akih-san/EMU8088_57Q_CPM86/tool/read_me.txt

mkinc.c

バイナリファイルから、ファームウェアに取り込む
インクルードファイルを作成するツールです。

それぞれの開発環境に合わせて、コンパイルして
実行ファイルを作成してください。

一応Windows用のmkinc.exeを添付していますが、
セキュリティが働いて実行できないかもしれません。
その場合は、開発マシンでコンパイルし、exeファイルを
作成してください。
