akih-san/EMU8088_57Q_CPM86/i88/Make include file.txt

＜cbios.incの作成方法＞

8086のアセンブラは、Macro Assembler AS V1.42を使用しています。
http://john.ccac.rwth-aachen.de:8000/as/

「PowerShell」のスクリプトを使用するため、windowsのターミナルは、
「Windows PowerShell」を使用してください。

初期状態では、スクリプトの実行が許可されていないため、
管理者権限でWindows PowerShellを起動し、以下の文を実行してください。

PowerShell Set-ExecutionPolicy RemoteSigned

上記コマンドを実行後は、管理者権限は必要ありません。
ノーマル権限のWindows PowerShellでスクリプトが使えるようになります。

インクルードファイルを作成するためのバッチファイルが用意されていますので、
バッチファイルを実行することで、インクルードファイルが自動的に作成されます。
Windows PowerShellを立ち上げて、作業ディレクトリへ移動してバッチファイルを
実行します。

（バッチコマンド）
./i88make.bat

作成されるインクルードファイル

1) unimon_8086.inc
2) cbios.inc

＜cbios.incの作成に関しての補足説明＞

1. ソースファイルをアセンブルする。

(コマンド）
asw -L cbios.asm

２．アセンブル後の中間ファイルから、２つのバイナリファイルを作る。
    プログラムがcodeと、dataで分かれているため、それぞれのバイナリを
    作成する必要がある。
    
(コマンド）
p2bin cbios.p cbios_code.bin -segment code
p2bin cbios.p cbios_data.bin -segment data

３．２つのバイナリファイルを１つに結合する。

(コマンド）
Get-Content cbios_*.bin -Encoding Byte | Set-Content cbios.bin -Encoding Byte

４．cbios.binからインクルードファイルを作成する

添付してあるmkinc.exeを実行して、インクルードファイルを作成する。
mkinc.exeの出力は、コンソールになっているので、パイプ「｜」または、リダイレクト「>」を
用いてファイルに出力する。

(コマンド）
.\mkinc.exe .\cbios.bin | sc cbios.inc
