akih-san/EMU8088_57Q_CPM86/circuit diagram.pdf

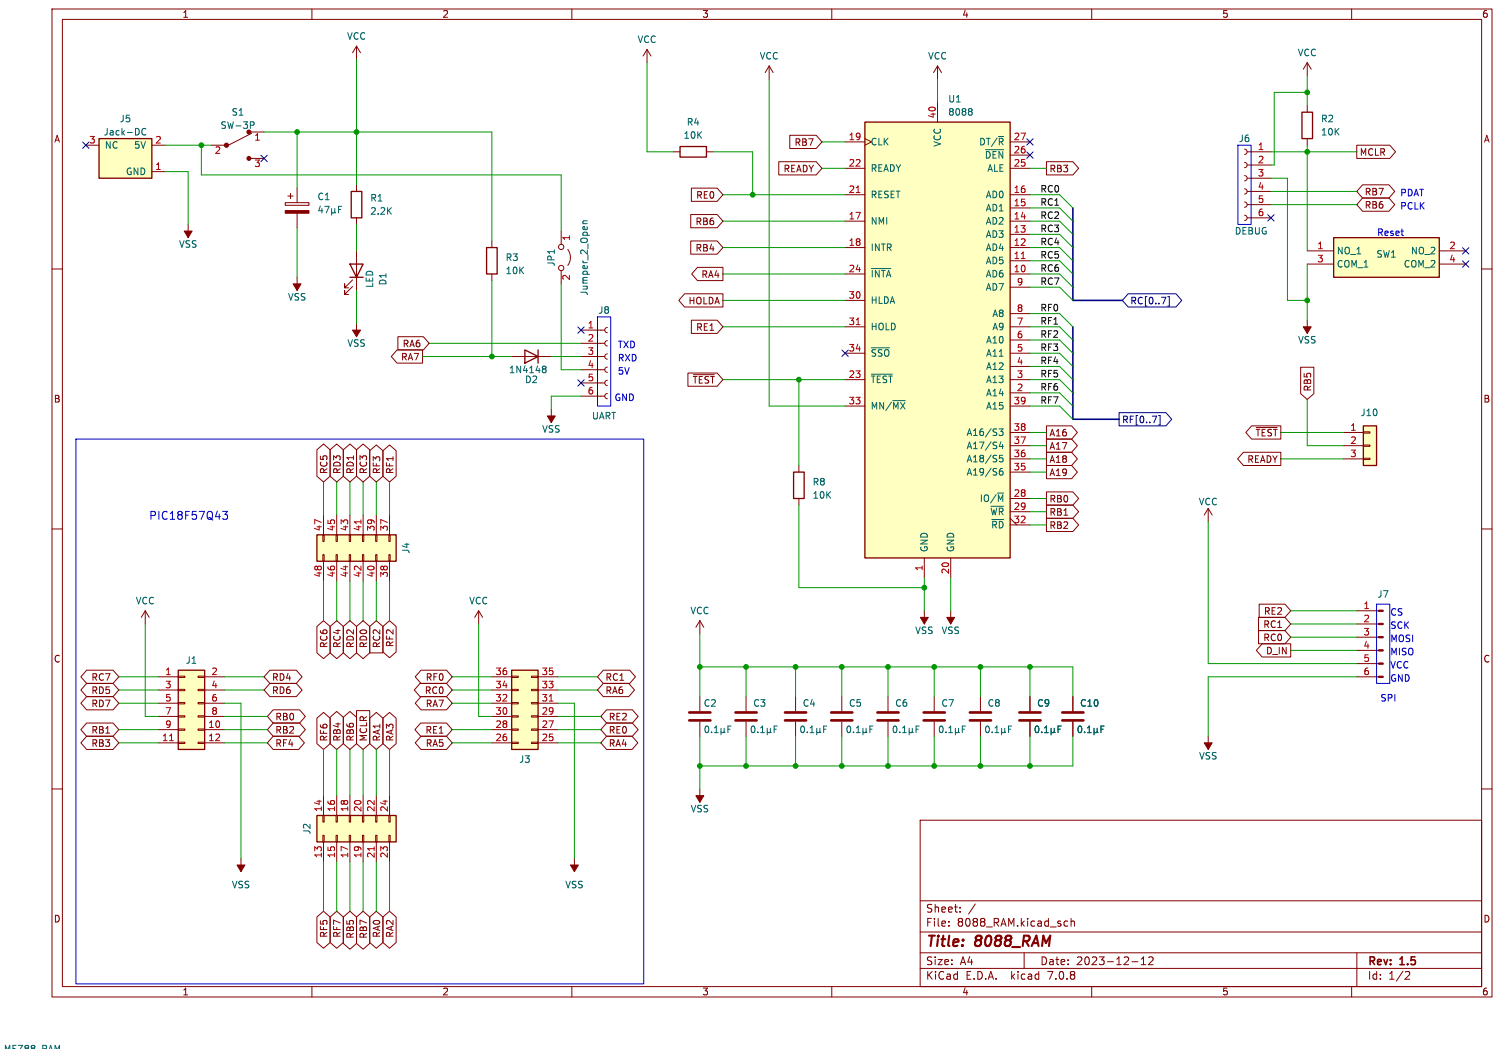
[picture p5: page 1]

PDAT PCLK
Reset VCC GND MISO

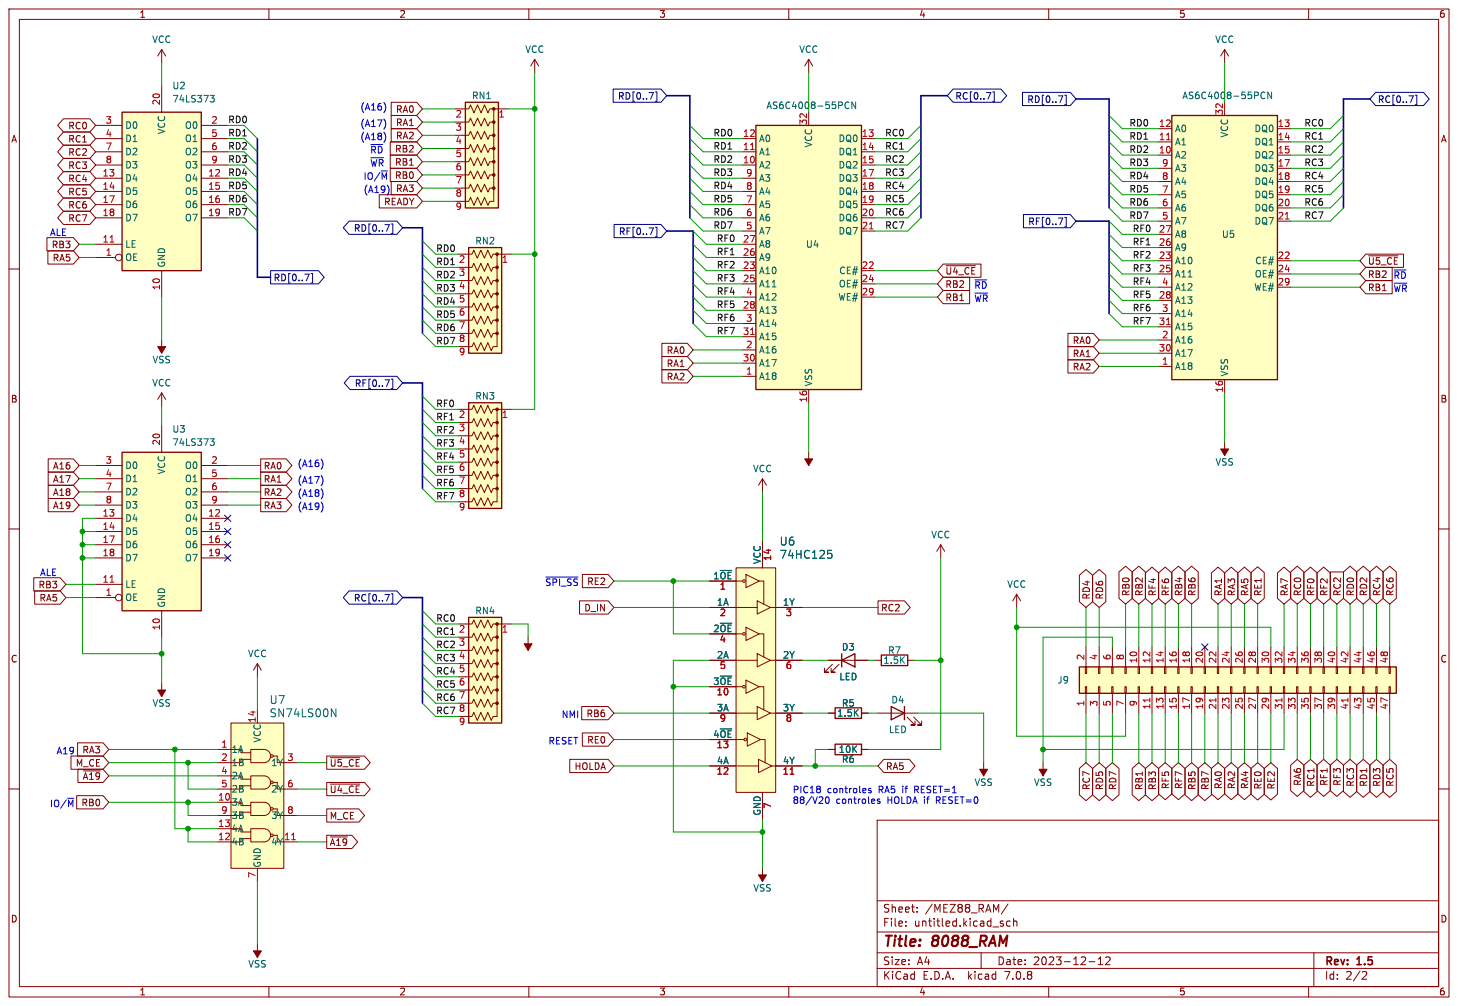
[picture p6: page 2]
