akih-san/EMU8088_57Q_CPM86/PCB_data/8088_RAM回路図.pdf

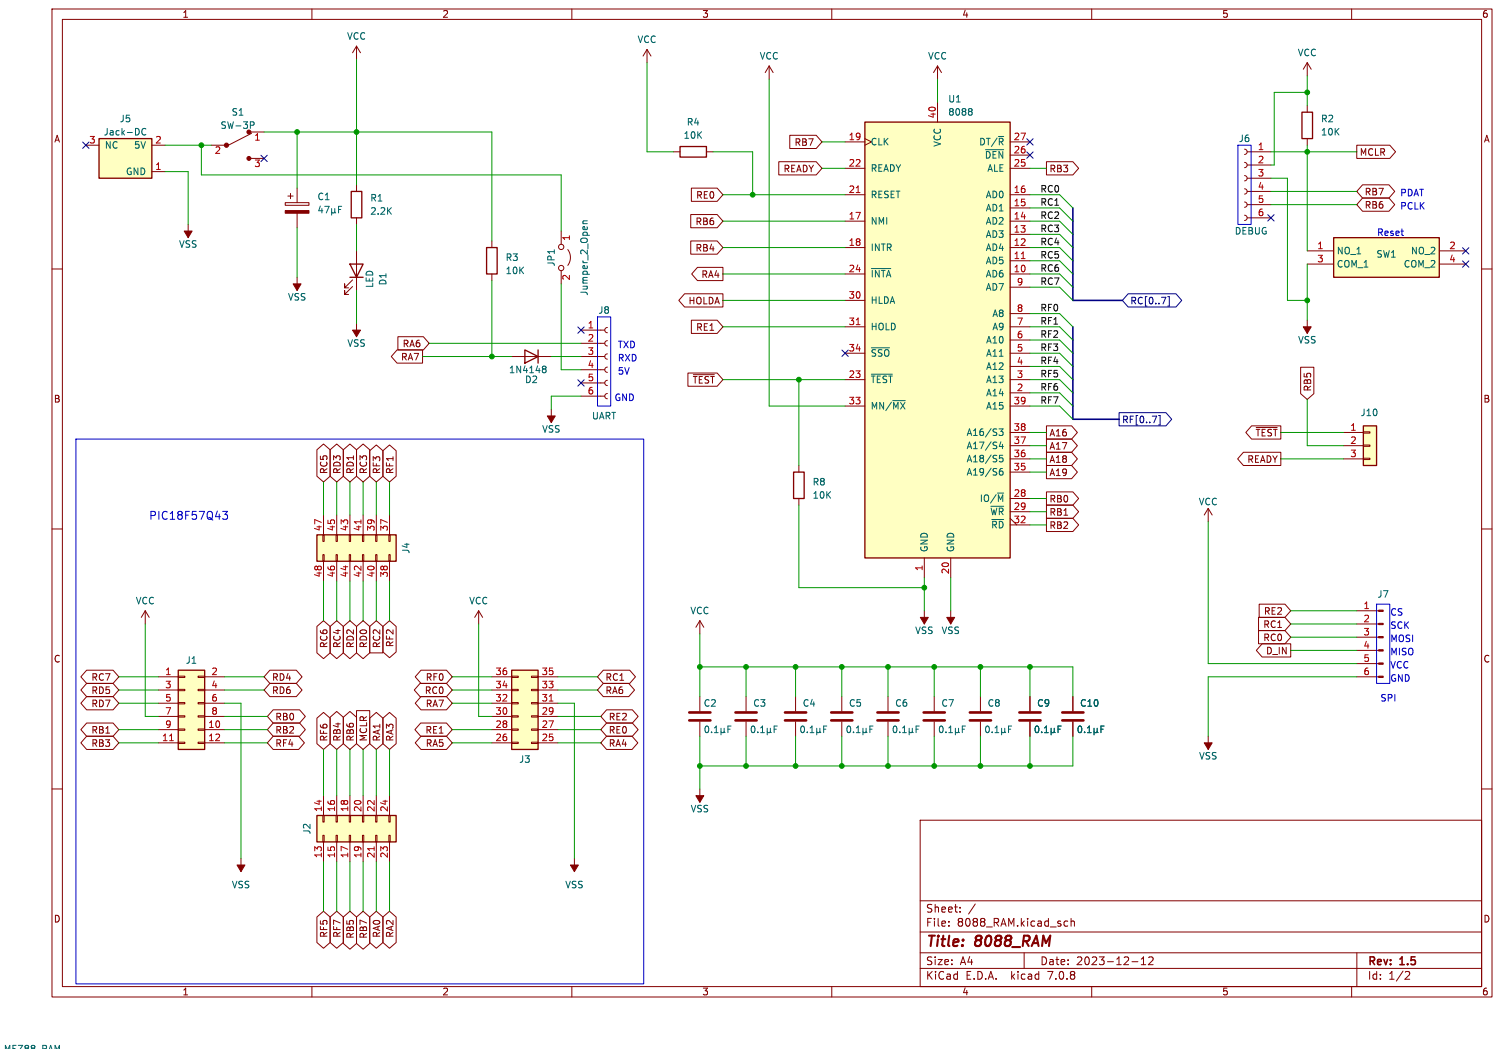
[picture p7: page 1]

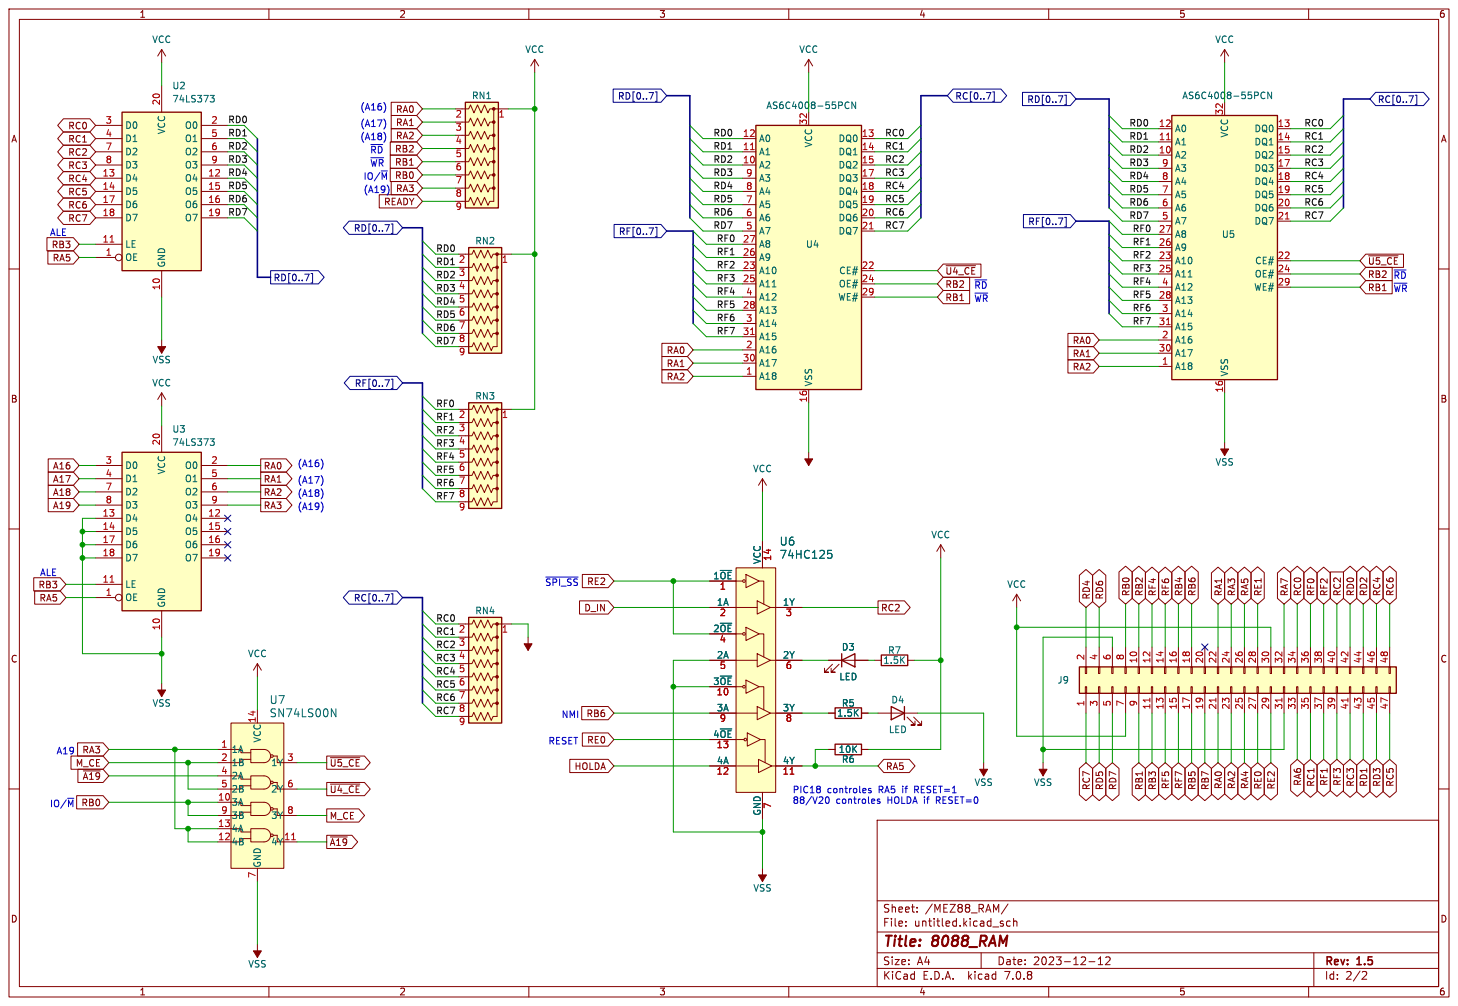
[picture p8: page 2]
